snckwf/controller-usb-raspberry-pico-recalbox/immagini/controller-pico-interno.png

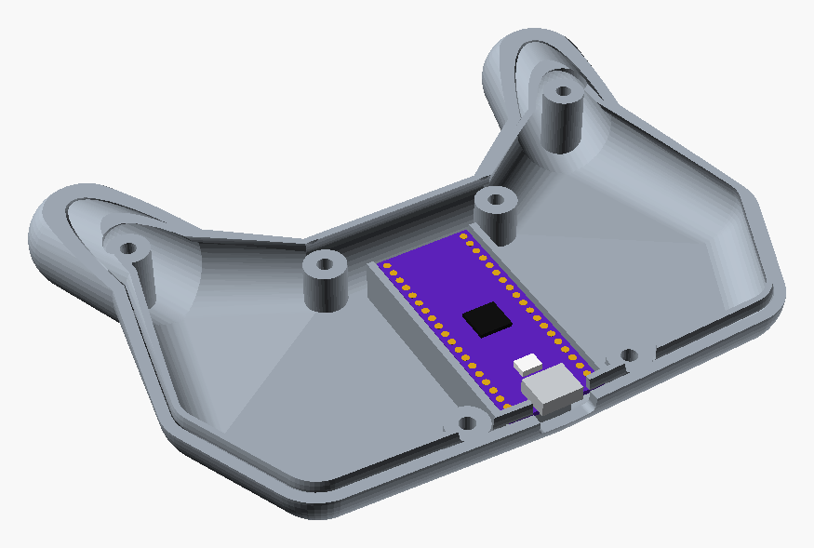
immagini/controller-pico-interno.png
