snckwf/controller-usb-raspberry-pico-recalbox/immagini/controller-pico-pezzi.png

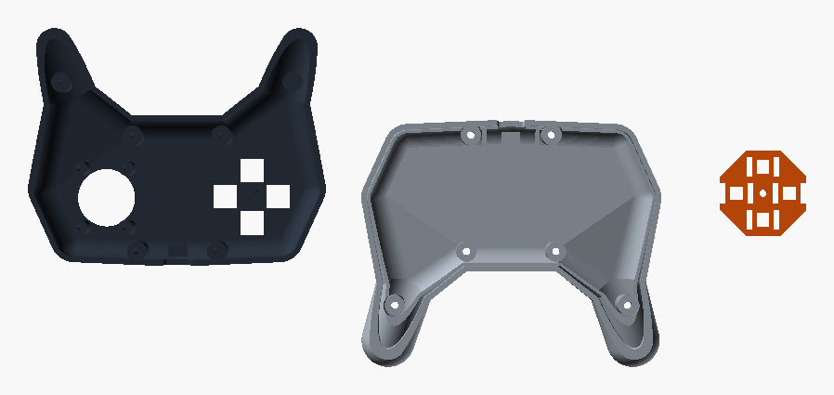
immagini/controller-pico-pezzi.png
