snckwf/controller-usb-raspberry-pico-recalbox/immagini/cover-controller-pico.png

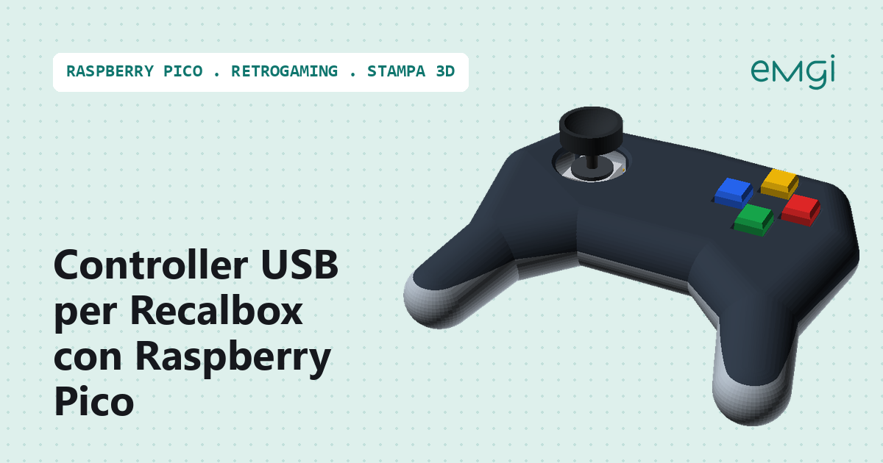
immagini/cover-controller-pico.png
