snckwf/controller-usb-raspberry-pico-recalbox/stl/controller_pico_sotto.stl

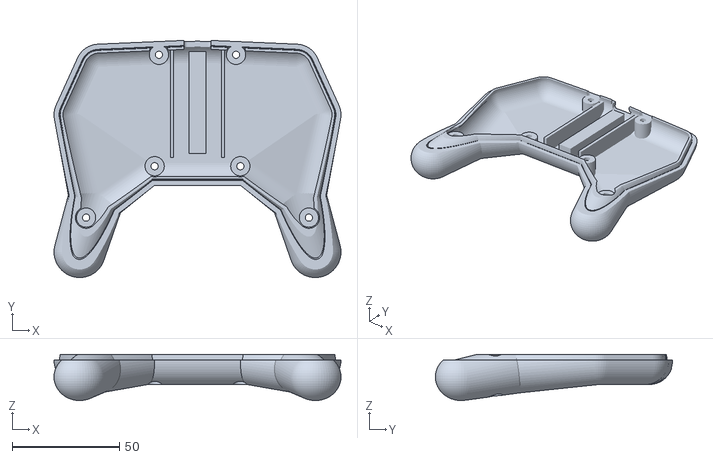
[picture p8: CAD file, 2026-10-20]
stl/controller_pico_sotto.stl
134.0 x 110.7 x 21.5
