snckwf/controller-usb-raspberry-pico-recalbox/stl/controller_pico_sopra.stl

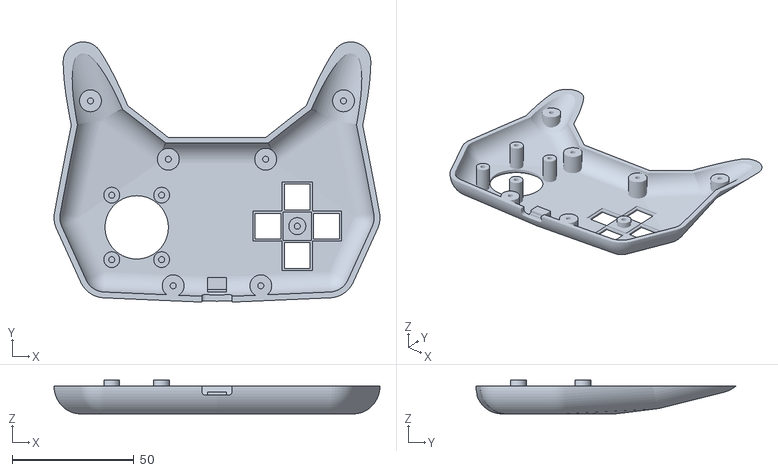
[picture p9: CAD file, 2026-10-20]
stl/controller_pico_sopra.stl
134.0 x 106.9 x 13.9
