snckwf/controller-usb-raspberry-pico-recalbox/stl/controller_pico_piastrina.stl

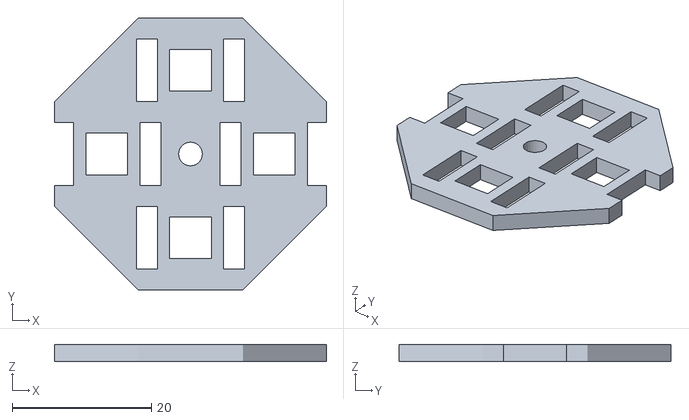
[picture p10: CAD file, 2026-10-20]
stl/controller_pico_piastrina.stl
39.0 x 39.0 x 2.50
