snckwf/controller-usb-raspberry-pico-recalbox/documentazione/guida_montaggio.html

Guida di montaggio e cablaggio

# Controller USB snello con Raspberry Pico

Un joystick KY-023 a sinistra, quattro pulsanti 12×12 a destra e un Raspberry Pi Pico dentro un guscio sottile da 23 mm, con le impugnature lunghe dei pad anni '90. Si collega con un cavo USB e viene riconosciuto come gamepad standard da PC, Recalbox, RetroPie, Batocera e Android, senza driver.

Controller montato

Controller visto di lato: corpo sottile

## Lista materiali

### Elettronica

Q.tà | Componente | Note
1 | Raspberry Pi Pico RP2040, clone TZT con USB-C | 21 × 51 mm, 40 piedini come il Pico originale, senza pin saldati. Va bene anche il Pico originale con micro-USB
1 | Modulo joystick analogico KY-023 | Con cappuccio della leva
4 | Pulsante tattile 12×12×7,3 con tappo quadrato 10×10 | Tappi verde, rosso, blu e giallo
1 | Cavo USB-C dati (non solo ricarica) | USB-A → USB-C per il Raspberry di Recalbox e per il PC; lungo 1,5–2 m

### Viteria

Q.tà | Componente | Dove
4 | Vite M3×12 testa cilindrica | Chiusura del corpo, da sotto (due dietro, due davanti)
2 | Vite M3×8 testa cilindrica | Chiusura nelle impugnature, da sotto
4 | Vite M3×6 testa tonda | Joystick
1 | Vite M3×6 testa tonda | Piastrina dei pulsanti

### Consumo

Q.tà | Materiale | Note
~90 g | Filamento PLA o PETG | Tre pezzi stampati, supporti compresi
~1,5 m | Filo flessibile 0,14–0,25 mm² | Meglio in 7 colori (vedi tabella dei collegamenti)
~10 cm | Guaina termorestringente 1,5–2 mm | Sulle saldature del joystick
— | Stagno, colla a caldo (facoltativa) | La colla blocca i fili e il Pico nella culla

### Attrezzi

Saldatore a punta fine, spellafili, tronchesino | Cacciavite a croce o brugola per le M3
Punta da 2,5 mm per ripassare i fori pilota | Cutter o sbavatore per i supporti

## Pezzi stampati

I tre pezzi nell'orientamento di stampa

Da sinistra: guscio sopra (capovolto, come va sul piatto), guscio sotto, piastrina pulsanti.

Pezzo | File | Orientamento | Supporti
Guscio sopra | controller_pico_sopra.stl | Capovolto, piano dei comandi sul piatto (già orientato nel file) | Ad albero, solo dal piatto, sotto le impugnature
Guscio sotto | controller_pico_sotto.stl | Com'è, apertura verso l'alto | Ad albero, solo dal piatto: poggia sulle punte delle impugnature
Piastrina pulsanti | controller_pico_piastrina.stl | Piatta | Nessuno

PLA o PETG, layer 0,2 mm, 3 perimetri, riempimento 20%. Ingombro 134 × 111 mm, spessore 23 mm al centro e 33 mm alle punte delle impugnature: entra in tutte le Kobra e nella i3 Mega S. Prima di stampare misura l'interasse dei fori del tuo KY-023 (joy_fori, 20,5 × 26,5), l'altezza della staffa metallica (joy_alt, 11,5), lo spessore del circuito del Pico (pm_sp, 1,0) e l'altezza della presa USB-C (usb_h, 3,2), e correggi i parametri nel file controller_pico.scad se servono.

## Collegamenti elettrici

Schema dei collegamenti. Arancio = 3,3 V, nero = GND, gli altri colori sono i segnali, uguali a quelli della tabella qui sotto.

Componente | Pin | Pico | Filo consigliato
Joystick KY-023 | GND | AGND (pin 33) | nero
| +5V | 3V3(OUT) (pin 36) | arancio
| VRx | GP26 (pin 31) | verde oliva
| VRy | GP27 (pin 32) | verde acqua
| SW (clic = L3 / FUNZIONE) | GP6 (pin 9) | viola
Pulsante A (basso) | piedino 1 | GP2 (pin 4) | verde
Pulsante B (destra) | piedino 1 | GP3 (pin 5) | rosso
Pulsante X (sinistra) | piedino 1 | GP4 (pin 6) | blu
Pulsante Y (alto) | piedino 1 | GP5 (pin 7) | giallo
4 pulsanti | piedino 4 | GND (pin 38 o un altro GND) | nero, un filo che passa da un pulsante all'altro

Il pin del joystick marcato +5V va collegato al 3V3(OUT) del Pico, non a VBUS o VSYS: con 5 V le uscite VRx/VRy superano i 3,3 V che gli ingressi reggono.

I numeri dei piedini contano da 1 (in alto a sinistra, accanto alla presa USB) scendendo sul lato sinistro fino al 20, poi risalgono sul lato destro dal 21 al 40. Il joystick va sulla massa analogica AGND (pin 33) per avere meno rumore sugli assi; i pulsanti su un GND qualsiasi (pin 3, 8, 13, 18, 23, 28, 38).

Sui pulsanti 12×12 i piedini dello stesso lato sono già collegati tra loro: se un pulsante risulta sempre premuto hai usato due piedini dello stesso lato. Prendi sempre due piedini in diagonale (1 e 4).

## Passi

I tre pezzi appena stampati

PASSO 1

### Prepara i pezzi

cutterpunta 2,5 mm

1. Togli i supporti dalle impugnature e pulisci il labbro di centraggio del guscio sotto.
2. Ripassa con la punta da 2,5 mm i fori pilota delle colonnine (joystick, piastrina e le 6 di chiusura).
3. Prova a vuoto: i tappi dei pulsanti devono scorrere nei fori quadrati senza forzare, e i due gusci devono chiudersi senza scalini.

Joystick montato sotto il guscio superiore

Guscio sopra capovolto: la schedina poggia sulle 4 colonnine

PASSO 2

### Salda i fili e monta il joystick

KY-0234 × M3×65 fili da 15 cm

1. Salda 5 fili da 15 cm sul joystick, direttamente sui pin a 90° (accorciali a 3–4 mm): i connettori Dupont non ci stanno. Infila la guaina su ogni saldatura.
2. Metti il guscio sopra capovolto sul banco. Infila la leva nel foro da 26 mm a sinistra e appoggia la schedina sulle 4 colonnine, con il connettore verso il retro.
3. Avvita le M3×6 senza stringere troppo: la plastica si filetta da sola.
4. Muovi la leva in tutte le direzioni: non deve toccare il bordo del foro.

Pulsanti e piastrina montati

Pulsanti nelle sedi, piastrina arancione sopra, vite al centro

PASSO 3

### Pulsanti e piastrina

4 pulsanti 12×12piastrina1 × M3×6

1. Monta i tappi sui pulsanti: giallo Y in alto, rosso B a destra, blu X a sinistra, verde A in basso.
2. Salda il filo del segnale sul piedino 1 di ogni pulsante e la catena di massa sul piedino 4 (in diagonale).
3. Infila i pulsanti dall'interno: il tappo esce dal foro quadrato, il corpo entra nella sede da 12,4 mm.
4. Appoggia la piastrina: le zampette entrano nelle asole e i fili escono dai fori centrali.
5. Fissala con la M3×6 nella colonnina centrale e prova che tutti e 4 facciano clic.

Pico nella culla del guscio inferiore

Il Pico nella culla, presa USB-C nella finestra posteriore

PASSO 4

### Carica il firmware e monta il Pico

Arduino IDERaspberry Pi PicoBOOTSEL

1. Nel Gestore schede installa Raspberry Pi Pico/RP2040/RP2350 di Earle F. Philhower. Non servono librerie: il gamepad USB è incluso.
2. Prima di saldare, tieni premuto il tasto BOOTSEL del Pico mentre colleghi il cavo: compare come unità RPI-RP2.
3. Apri controller_pico.ino, scegli la scheda Raspberry Pi Pico e come porta UF2_Board, poi Carica.
4. Appoggia il Pico nella culla del guscio sotto, componenti verso l'alto, con la presa USB-C infilata nella finestra posteriore.
5. Salda i fili nei fori dei piedini dal lato dei componenti, seguendo la tabella dei collegamenti. Lasciali lunghi abbastanza da aprire i gusci a libro.
6. Facoltativo: un punto di colla a caldo sul fondo della culla. La presa viene comunque bloccata dal dente del guscio sopra.

I caricamenti successivi non richiedono BOOTSEL: l'IDE riavvia il Pico da solo attraverso la porta USB, anche a controller chiuso.

PASSO 5

### Collaudo a gusci aperti

joy.cplmonitor seriale

1. Collega il cavo USB senza toccare la leva: all'avvio il firmware misura il centro del joystick e il LED del Pico lampeggia due volte. Il LED si accende mentre premi un pulsante.
2. Su Windows premi Win+R, scrivi joy.cpl e apri le Proprietà del controller: controlla i 2 assi, la croce (POV) e i pulsanti.
3. Se un asse va al contrario o è scambiato, cambia in testa allo sketch INVERTI_X, INVERTI_Y o SCAMBIA_XY e ricarica.
4. Per vedere i valori grezzi apri il monitor seriale e invia d.

Chiusura dei due gusci

Il guscio sopra scende sul labbro, le 6 viti entrano da sotto

PASSO 6

### Chiudi il controller

4 × M3×122 × M3×8

1. Raccogli i fili lontano dalla leva e dalla piastrina: nessun filo deve stare sotto la schedina del joystick.
2. Appoggia il guscio sopra sul labbro di centraggio del guscio sotto.
3. Avvita da sotto le 4 M3×12 nel corpo (due dietro, due davanti) e le 2 M3×8 nelle impugnature: lì il guscio è più basso e una vite lunga uscirebbe dalla superficie.
4. Stringi a croce e senza forzare: se i gusci non chiudono, c'è un filo schiacciato.

Retro del controller con la presa USB

La presa USB-C al centro del retro

PASSO 7

### Configura e usa

RecalboxPC

Con soli 4 pulsanti, Start e Select si ottengono tenendo premuto il clic del joystick (tasto FUNZIONE):

Combinazione | Funzione
L3 + Y | START
L3 + X | SELECT (hotkey di Recalbox)
L3 + A | L1
L3 + B | R1
L3 premuto e lasciato | clic L3
L3 tenuto da solo per 5 secondi | ricalibra il centro dello stick

1. Recalbox: collega il controller a una porta USB del Raspberry. Dal menu (Start) › Impostazioni controller › Configura un controller, segui le richieste: per la croce direzionale muovi lo stick (il firmware invia anche una croce digitale ricavata dallo stick), per Start, Select e Hotkey usa le combinazioni qui sopra.
2. PC: Steam e la maggior parte dei giochi lo vedono come gamepad generico; in Steam configuralo una volta da Impostazioni › Controller.
3. Se un gioco non vuole la croce digitale insieme allo stick, metti CROCE_DA_STICK a 0 nello sketch.

## Problemi comuni

Sintomo | Causa probabile | Rimedio
Il PC non vede il controller | Cavo USB-C solo ricarica | Prova un cavo dati: con un cavo buono il Pico compare come gamepad e come porta COM
L'IDE non trova la porta per caricare | Firmware bloccato o primo caricamento | Stacca il cavo, tieni premuto BOOTSEL, ricollega e carica sulla porta UF2_Board
Lo stick deriva da solo | Leva toccata mentre colleghi il cavo | Tieni premuto il clic della leva per 5 secondi, a leva ferma
Asse al contrario o scambiato | Orientamento del modulo KY-023 | Cambia INVERTI_* o SCAMBIA_XY nello sketch
Lo stick arriva a fondo corsa a metà movimento | Joystick alimentato a 5 V invece che a 3,3 V | Sposta il filo +5V del modulo sul pin 3V3(OUT)
Un pulsante risulta sempre premuto | Fili su due piedini dello stesso lato | Sposta il filo sul piedino in diagonale
La leva tocca il bordo del foro | Modulo con escursione più ampia | Aumenta joy_foro nel file .scad e ristampa il guscio sopra
I gusci non chiudono | Filo schiacciato, oppure il dente sopra la presa USB-C preme troppo | Riapri e sposta i fili; se tocca la presa, misura pm_sp e usb_h, correggili e ristampa il guscio sopra

File del progetto: controller_pico.scad (modello parametrico), controller_pico_sopra.stl, controller_pico_sotto.stl, controller_pico_piastrina.stl, sketch controller_pico.ino e schema schema_collegamenti.svg / .png.
