snckwf/controller-usb-raspberry-pico-recalbox/(commit log)

2026-10-20 Controller USB per Recalbox e PC con Raspberry Pico, joystick e guscio stampato in 3D
    Articolo: https://www.emgi.it/2026/10/20/controller-usb-raspberry-pico-recalbox-stampato-3d/
    Claude-Session: https://claude.ai/code/session_01MPLkZQfPtZwGyS87VpSVuS
    [controller_pico.scad, controller_pico_piastrina.stl, controller_pico_sopra.stl, controller_pico_sotto.stl]
2026-10-20 Aggiornamento del progetto
    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
